UnderCapsLock/iotlamp/screenshots/advanced.png

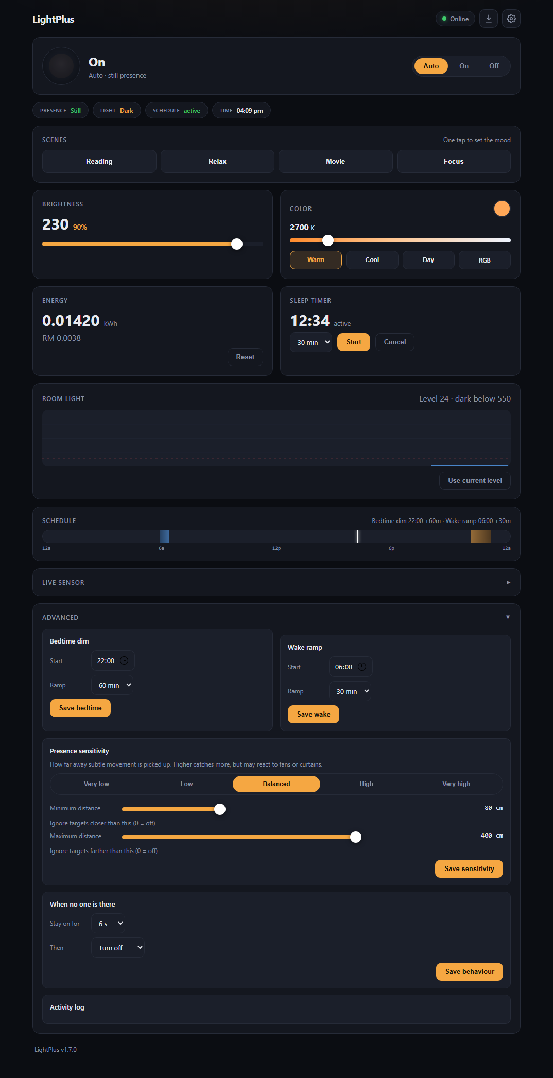
screenshots/advanced.png
