UnderCapsLock/iotlamp/config.h

#pragma once

#include <stdint.h>

#define CONFIG_VERSION   6
#define CONFIG_NAMESPACE "lamp_cfg"

struct RuntimeConfig {
    uint8_t  config_version;

    uint8_t  bedtime_start_hour;
    uint8_t  bedtime_start_minute;
    uint16_t bedtime_duration_s;

    uint8_t  wake_start_hour;
    uint8_t  wake_start_minute;
    uint16_t wake_duration_s;

    uint16_t dark_threshold;

    uint16_t presence_hold_s;
    uint8_t  presence_lost;

    uint16_t radar_min_dist_cm;
    uint16_t radar_max_dist_cm;

    uint8_t  mqtt_enabled;
    uint16_t mqtt_port;
    char     mqtt_host[64];
    char     mqtt_user[32];
    char     mqtt_pass[32];
};

extern RuntimeConfig g_config;

void loadConfig();
void saveConfig();

void setBedtimeWindow(uint8_t startH, uint8_t startM, uint16_t durationS);
void setWakeWindow(   uint8_t startH, uint8_t startM, uint16_t durationS);
void setDarkThreshold(uint16_t value);
void setPresenceBehavior(uint16_t holdS, uint8_t lostAction);
void setRadarMinDist(uint16_t cm);
void setRadarMaxDist(uint16_t cm);
void setMqttConfig(uint8_t enabled, const char *host, uint16_t port, const char *user, const char *pass);
