UnderCapsLock/iotlamp/tools/healthcheck.py

#!/usr/bin/env python3
"""LightPlus system health check with diagnosis.

Runs from check.bat (double-click) or:
    python tools/healthcheck.py [--ip 192.168.0.7] [--mac-suffix b9-c9-fc]

Each failing check prints the likely cause and how to fix it.
Requires: pip install paho-mqtt (for the broker checks)
"""

import argparse
import base64
import json
import os
import re
import socket
import subprocess
import sys
import time
import urllib.request
from concurrent.futures import ThreadPoolExecutor

RESULTS = []

FIXES = {
    "Lamp discovered": "Is the lamp powered? Wait ~30s after power-on. Same WiFi as this PC? "
                       "If WiFi changed, connect to the 'LightPlus-Setup' network and open 192.168.4.1.",
    "Dashboard reachable": "Wrong IP, or the lamp's dashboard is down. Run without --ip to auto-discover; "
                           "if the IP is right, power-cycle the lamp.",
    "WebSocket state": "Power-cycle the lamp; if it persists, reflash the firmware (Arduino IDE network port).",
    "Radar streaming": "Radar lost power or data: check the red (5V) and black (GND) wires first, "
                       "then TX->GPIO16 and RX->GPIO17. It recovers by itself within seconds once data flows.",
    "Lamp MQTT connected": "Check that the broker host equals this laptop's IP (see WARNING above) and that "
                           "Docker is running. Fix in the dashboard: Settings -> MQTT.",
    "MQTT broker port 1883": "Docker/broker is down. Open Docker Desktop, then run: "
                             "docker compose -f tools\\home-assistant\\docker-compose.yml up -d",
    "Broker availability": "The lamp is not publishing to the broker - see 'Lamp MQTT connected'.",
    "Broker retained state": "Broker is up but no lamp data - wait 10 seconds and run the check again.",
    "Broker checks": "Either paho-mqtt is not installed (pip install paho-mqtt) or the broker is down "
                     "(start Docker Desktop).",
    "Docker containers": "Docker Desktop must be running. Containers start automatically once it is; "
                         "if not, run docker compose up -d in tools\\home-assistant.",
    "Home Assistant UI": "Home Assistant needs 1-2 minutes after Docker starts - wait and re-run.",
}


def report(name, ok, detail="", fix=None):
    mark = "PASS" if ok else "FAIL"
    print(f"[{mark}] {name}" + (f" -- {detail}" if detail else ""))
    text = None
    if not ok:
        text = fix or FIXES.get(name)
        if text:
            print(f"        -> {text}")
    RESULTS.append((name, ok, text))


def note(name, value):
    print(f"       {name}: {value}")


def local_ip():
    s = socket.socket(socket.AF_INET, socket.SOCK_DGRAM)
    try:
        s.connect(("8.8.8.8", 80))
        return s.getsockname()[0]
    finally:
        s.close()


def arp_find(mac_suffix):
    suffix = mac_suffix.lower().replace(":", "-")
    try:
        out = subprocess.run(["arp", "-a"], capture_output=True, text=True, timeout=10).stdout
    except Exception:
        return None
    for m in re.finditer(r"(\d+\.\d+\.\d+\.\d+)\s+([0-9a-fA-F-]{17})", out):
        ip, mac = m.group(1), m.group(2).lower()
        if mac.endswith(suffix):
            return ip
    return None


def discover(mac_suffix, ip_hint=None):
    if ip_hint:
        return ip_hint
    try:
        return socket.gethostbyname("lightplus.local")
    except Exception:
        pass
    found = arp_find(mac_suffix)
    if found:
        return found
    print("       scanning the network for the lamp...")
    ip = local_ip()
    subnet = ip.rsplit(".", 1)[0]

    def ping(i):
        subprocess.run(["ping", "-n", "1", "-w", "150", f"{subnet}.{i}"],
                       capture_output=True, timeout=5)

    with ThreadPoolExecutor(max_workers=64) as ex:
        list(ex.map(ping, range(1, 255)))
    return arp_find(mac_suffix)


class WsConn:
    def __init__(self, ip, timeout=6):
        self.s = socket.create_connection((ip, 80), timeout=timeout)
        self.buf = b""
        key = base64.b64encode(os.urandom(16)).decode()
        req = (f"GET /ws HTTP/1.1\r\nHost: {ip}\r\nUpgrade: websocket\r\n"
               f"Connection: Upgrade\r\nSec-WebSocket-Key: {key}\r\n"
               f"Sec-WebSocket-Version: 13\r\n\r\n")
        self.s.sendall(req.encode())
        buf = b""
        while b"\r\n\r\n" not in buf:
            chunk = self.s.recv(1024)
            if not chunk:
                self.close()
                raise RuntimeError("connection closed during handshake")
            buf += chunk
        head, rest = buf.split(b"\r\n\r\n", 1)
        if b"101" not in head.split(b"\r\n")[0]:
            self.close()
            raise RuntimeError("websocket upgrade rejected")
        self.buf = rest

    def next_state(self, timeout=6):
        end = time.time() + timeout
        while time.time() < end:
            self.s.settimeout(max(0.5, end - time.time()))
            frame = parse_frame(self.buf)
            while frame is None:
                chunk = self.s.recv(2048)
                if not chunk:
                    raise RuntimeError("connection closed")
                self.buf += chunk
                frame = parse_frame(self.buf)
            (opcode, payload), self.buf = frame
            if opcode == 1:
                try:
                    msg = json.loads(payload.decode("utf-8", "replace"))
                    if "dark" in msg:
                        return msg
                except Exception:
                    pass
        raise RuntimeError("no state message received")

    def send(self, text):
        payload = text.encode()
        mask = os.urandom(4)
        header = bytearray([0x81])
        n = len(payload)
        if n < 126:
            header.append(0x80 | n)
        elif n < 65536:
            header.append(0x80 | 126)
            header += n.to_bytes(2, "big")
        else:
            header.append(0x80 | 127)
            header += n.to_bytes(8, "big")
        header += mask
        masked = bytes(b ^ mask[i % 4] for i, b in enumerate(payload))
        self.s.sendall(bytes(header) + masked)

    def close(self):
        try:
            self.s.close()
        except Exception:
            pass


def fix_mqtt_host(ip, host):
    try:
        conn = WsConn(ip)
    except Exception:
        return False
    try:
        conn.send(json.dumps({"cmd": "set_mqtt", "enabled": 1,
                              "host": host, "port": 1883}))
        end = time.time() + 15
        while time.time() < end:
            try:
                st = conn.next_state(6)
            except Exception:
                break
            if st.get("mqtt_host") == host:
                return True
        return False
    finally:
        conn.close()


def read_ws_state(ip, timeout=6):
    conn = WsConn(ip, timeout)
    try:
        return conn.next_state(timeout)
    finally:
        conn.close()


def parse_frame(buf):
    if len(buf) < 2:
        return None
    opcode = buf[0] & 0x0F
    length = buf[1] & 0x7F
    idx = 2
    if length == 126:
        if len(buf) < 4:
            return None
        length = int.from_bytes(buf[2:4], "big")
        idx = 4
    elif length == 127:
        if len(buf) < 10:
            return None
        length = int.from_bytes(buf[2:10], "big")
        idx = 10
    if len(buf) < idx + length:
        return None
    return (opcode, buf[idx:idx + length]), buf[idx + length:]


def http_ok(url, timeout=5):
    try:
        with urllib.request.urlopen(url, timeout=timeout) as r:
            return r.status == 200
    except Exception:
        return False


def broker_retained():
    try:
        import paho.mqtt.client as mqtt
    except ImportError:
        return None, None
    got = {}

    def on_message(c, u, m):
        got[m.topic] = m.payload.decode(errors="replace")

    c = mqtt.Client(mqtt.CallbackAPIVersion.VERSION2, client_id="healthcheck_py")
    c.on_message = on_message
    try:
        c.connect("127.0.0.1", 1883, 10)
    except Exception:
        return None, None
    c.subscribe("lightplus/+/availability")
    c.subscribe("lightplus/+/state")
    c.loop_start()
    time.sleep(3)
    c.loop_stop()
    c.disconnect()
    avail = next((v for k, v in got.items() if k.endswith("/availability")), None)
    state = next((v for k, v in got.items() if k.endswith("/state") and "ha/" not in k), None)
    return avail, state


def docker_exe():
    path = os.path.join(os.environ.get("LOCALAPPDATA", ""),
                        "Programs", "DockerDesktop", "resources", "bin", "docker.exe")
    return path if os.path.exists(path) else "docker"


def docker_status():
    try:
        out = subprocess.run([docker_exe(), "ps", "--format", "{{.Names}}={{.Status}}"],
                             capture_output=True, text=True, timeout=20).stdout
        return out.strip().splitlines()
    except Exception:
        return []


def start_docker_desktop():
    exe = os.path.join(os.environ.get("LOCALAPPDATA", ""), "Programs",
                       "DockerDesktop", "Docker Desktop.exe")
    if not os.path.exists(exe):
        return False
    print("       Docker Desktop is not running - starting it (this can take ~1 minute)...")
    subprocess.Popen([exe], stdout=subprocess.DEVNULL, stderr=subprocess.DEVNULL)
    for _ in range(18):
        time.sleep(5)
        if docker_status():
            print("       Docker is up.")
            return True
    return False


def main():
    ap = argparse.ArgumentParser()
    ap.add_argument("--ip", help="lamp IP (skips discovery)")
    ap.add_argument("--mac-suffix", default="b9-c9-fc", help="lamp MAC suffix for discovery")
    args = ap.parse_args()

    print("LightPlus Health Check")
    print("=" * 50)
    lip = local_ip()
    note("Laptop IP", lip)

    ip = discover(args.mac_suffix, args.ip)
    report("Lamp discovered", bool(ip), ip or "not found")
    if not ip:
        finish()
        return

    report("Dashboard reachable", http_ok(f"http://{ip}/"), f"http://{ip}/")

    state = None
    try:
        state = read_ws_state(ip)
        report("WebSocket state", True, f"fw {state.get('fw')}, uptime {state.get('uptime_s')}s")
    except Exception as e:
        report("WebSocket state", False, str(e))

    if state:
        time.sleep(3)
        try:
            state2 = read_ws_state(ip)
            delta = state2.get("radar_frames", 0) - state.get("radar_frames", 0)
            report("Radar streaming", delta > 0 or state2.get("radar_frames", 0) > 0,
                   f"frames +{delta} in 3s (total {state2.get('radar_frames')})")
        except Exception as e:
            report("Radar streaming", False, str(e))
        note("Presence", state.get("presence"))
        note("Room", "dark" if state.get("dark") else "bright")
        mqtt_state = state
        if state.get("mqtt_host") and state["mqtt_host"] != lip:
            print(f"[FIX ] Lamp uses current laptop IP -- lamp targets {state['mqtt_host']}, laptop is {lip}")
            print(f"        -> auto-fixing: pointing the lamp at {lip}...")
            if fix_mqtt_host(ip, lip):
                note("Auto-fix", f"lamp MQTT host updated to {lip}")
                try:
                    mqtt_state = read_ws_state(ip)
                except Exception:
                    pass
                report("Lamp uses current laptop IP", bool(mqtt_state.get("mqtt_host") == lip),
                       f"auto-fixed to {lip}",
                       fix=f"Still wrong - set host to {lip} in the dashboard: Settings -> MQTT")
            else:
                report("Lamp uses current laptop IP", False,
                       f"lamp targets {state['mqtt_host']}, laptop is {lip}",
                       fix="Auto-fix failed - set it in the dashboard: Settings -> MQTT")
        report("Lamp MQTT connected", bool(mqtt_state.get("mqtt_on")),
               f"broker {mqtt_state.get('mqtt_host')}:{mqtt_state.get('mqtt_port')}")

    report("MQTT broker port 1883", socket_test("127.0.0.1", 1883))
    avail, retained = broker_retained()
    if avail is not None:
        report("Broker availability", avail == "online", f"lamp says '{avail}'")
        report("Broker retained state", retained is not None,
               "receiving" if retained else "no retained state topic")
    else:
        report("Broker checks", False, "paho-mqtt missing or broker unreachable")

    containers = docker_status()
    if not containers:
        start_docker_desktop()
        containers = docker_status()
    ha = any(c.startswith("lightplus-homeassistant=Up") for c in containers)
    mq = any(c.startswith("lightplus-mosquitto=Up") for c in containers)
    report("Docker containers", ha and mq,
           ", ".join(containers) if containers else "docker not running")

    report("Home Assistant UI", http_ok("http://localhost:8123"), "http://localhost:8123")

    finish()


def socket_test(host, port):
    try:
        with socket.create_connection((host, port), timeout=3):
            return True
    except Exception:
        return False


def finish():
    fails = [(n, f) for n, ok, f in RESULTS if not ok]
    print("-" * 50)
    if fails:
        print(f"RESULT: {len(fails)} problem(s) found:")
        for n, f in fails:
            print(f"  - {n}" + (f" -> {f}" if f else ""))
        sys.exit(1)
    print("RESULT: all checks passed - system ready")
    sys.exit(0)


if __name__ == "__main__":
    main()
