UnderCapsLock/iotlamp/(commit log)

2026-07-25 Working state before OTA - dashboard, sensors, energy tracking, scheduling all functional
2026-07-25 Feature-complete: sensors, dashboard, OTA, ESP32-hosted UI all verified working
2026-09-21 LightPlus 1.1.0: PWA dashboard overhaul, radar watchdog + blink fixes, CI
    - Split dashboard into data/index.html + app.css + app.js, PWA manifest/service worker/icons with install support
    - Radar stream watchdog with auto-restart, boot-time RX/TX auto-detect, presence hold and LDR hysteresis to stop blinking
    - Wi-Fi country config for channels 12-13, sleep timer 30s fade to off, OTA freeze fix
    - Rebrand to LightPlus with logo slot and firmware version in state broadcast
    - GitHub Actions compile check, tools/test_ws.mjs test suite, CHANGELOG, vendored MyLD2410, README updates and dashboard screenshot
    [iotlamp.ino]
2026-09-21 Dashboard polish: scenes, radar visual, ambient tint, smooth orb, plain-language UI
    - Scenes with hover tooltips (Reading/Relax/Movie/Focus)
    - Live radar sweep with target dot and distance
    - Ambient tint follows lamp color; orb fades via 60fps lerp
    - Presence sensitivity as 5 friendly levels, replaces raw sliders
    - Removed OUT/RX pins, Readings, watt estimate; plain-language labels
    - Radar online flag follows frame flow; browser OTA removed (unstable)
    [iotlamp.ino]
2026-09-21 Dashboard: instant mode confirm, true fades, radar 3m view, schedule timeline, night/offline modes
    - Firmware broadcasts state immediately after every command (20-30ms confirm, was 1-2s) and WS interval now 1s
    - Orb fades use constant-speed curve both directions; On/Off labels replace Forced On/Off
    - Radar visual: 3m range, sweep wedge, halos, legend
    - Night mode dims after 11pm; offline state dims UI; schedule timeline with ramp bands
    - Count-up numbers, CCT gradient track, LDR chart fill; manifest served as application/manifest+json
    [iotlamp.ino, pins.h]
2026-09-22 Firmware 1.2.0: captive-portal provisioning, optional auth, presence behaviour, logic.h
    - AP setup fallback (LightPlus-Setup) with /wifi page; NVS credentials override compile-time
    - Optional WS_TOKEN auth with per-client authorization
    - Configurable presence hold and night-light behaviour (NVS config v3)
    - LDR fault detection; rate-limited WiFi reconnect; WS frame buffer overrun fix
    - Schedule/easing/kelvin math extracted to logic.h for host tests
    [config.cpp, config.h, iotlamp.ino, logic.h]
2026-09-22 Repo: host logic tests in CI, release workflow, integration and hardware docs
    - tests/logic_test.cpp + CI job (g++ native)
    - release.yml: tagged builds attach firmware + littlefs artifacts
    - docs/INTEGRATIONS.md (HA/HomeKit/Matter plan), docs/HARDWARE.md (wiring/BOM), ROADMAP.md, CONTRIBUTING.md, SECURITY.md, issue templates
    - README: new features, API fields, documentation index; tools updated
2026-09-22 Docs: v1.2 dashboard screenshot (live radar, timeline) and demo powerbank note
2026-09-22 Firmware 1.3.0: MQTT + Home Assistant discovery
    - PubSubClient integration with availability LWT, retained discovery payloads, state publishing
    - HA light JSON schema (state, brightness, color_temp mireds, RGB) plus native cmd passthrough
    - MQTT config in NVS (host/port/user/pass/enabled), set_mqtt WS command, config v4 with graceful migration
    - Device id and MQTT status exposed in state broadcast
2026-09-22 Firmware 1.4.0: up to 3 saved WiFi networks + Change WiFi button
    - WiFiMulti-based network selection (home + hotspot coexist)
    - wifi_setup command / Settings button starts LightPlus-Setup AP on demand
    - wifi_nets reported in state broadcast
2026-09-22 Firmware: deterministic WiFi order (home first, hotspot fallback); HA dashboard YAML
    - Reverted WiFiMulti: sequential connect attempts, home network preferred, last-successful cached for the session
    - Fixes connection cycling when both home WiFi and a phone hotspot are saved
    - tools/home-assistant/lightplus-dashboard.yaml: sections dashboard for HA
    [iotlamp.ino]
2026-09-22 Firmware: non-blocking radar recovery (fixes 3-4s main-loop stalls)
    - Radar UART restart no longer calls begin() (which blocks up to 4s); frames arriving mark it online again
    - MQTT command latency drops from ~3s to ~160ms when the radar is offline
    [iotlamp.ino]
2026-09-22 Firmware 1.5.0: Home Assistant Auto-mode switch
    - New MQTT switch entity returns the lamp to automatic control (off = force off)
    - HA sections dashboard gains an Auto mode tile
    - Changelog notes WiFi preference fix and non-blocking radar recovery
    [iotlamp.ino]
2026-09-27 tools: check.bat launcher + failure diagnosis in healthcheck
    - check.bat: double-click health check with pause and Python detection
    - every failing check prints likely cause + fix; summary repeats them
    - Docker Desktop auto-starts if containers are down
    [healthcheck.py]
2026-09-29 radar scan: also probe GPIO4 (OUT pin) for TX miswiring
2026-09-30 healthcheck: auto-fix lamp MQTT host on laptop IP change; Docker auto-start
    - detects IP mismatch and re-points the lamp over WebSocket automatically
    - resolved fixes report as PASS instead of remaining problems
    [healthcheck.py]
2026-09-30 Firmware 1.6.0: radar minimum-distance filter
    - set_min_distance command + NVS setting (0-600cm, 0 = off)
    - presence closer than the threshold is ignored (ceiling-mount tuning)
    - dashboard slider under Presence sensitivity; state reports min_dist
    - test suite extended (46 checks)
2026-09-30 Firmware 1.7.0: radar maximum-distance filter
    - set_max_distance command + NVS setting (0-600cm, 0 = off)
    - detection window now min+max; dashboard slider under Presence sensitivity
    - suite extended to 51 checks
2026-09-30 dashboard: merge min/max distance, MQTT, wifi, setup-AP and LDR fields into state (sliders snapped back to 0 on save)
    - currentState was missing min_dist/max_dist, mqtt_*, wifi_nets, ap, ldr_fault, ph_s/pl_act - incoming values were ignored
    - healthcheck auto-fix now verifies the host was applied instead of requiring the broker online
    [healthcheck.py]
2026-10-02 docs: user guide, refreshed screenshots (desktop/mobile/advanced), README + roadmap finalize
    - docs/USER-GUIDE.md: end-user setup, hotspot notes, troubleshooting, owner tools
    - new screenshots: current dashboard, mobile layout, advanced settings
    - README: gallery, updated features/dashboard sections, one-click tools, competition win
    - gitignore __pycache__
